taborgreat/robokyle-factum/band/software/README.md

# Band software

C firmware on the Pico SDK 2.2.0 (`firmware/`) plus MicroPython bench tools (`bench/`). The claw's firmware lives
in `claw/software/firmware` and speaks the same protocols. Pins: [../PINOUT.md](../PINOUT.md) (single source of truth). Wiring page: https://claude.ai/artifact/D63qQQRTtqdpi1PEdaQg2D

| dir | target | what |
|---|---|---|
| `firmware/` | Pico 2 W | EMG band: HAND-FACTUM / HAND-DIRECT / MOUSE / HAND-WIRED, config server, BLE HID mouse |
| `../../claw/software/firmware/` | Pico W | claw: hand API on :80, Feetech STS3215 bus, keepalive watchdog, cord |
| `bench/` | MicroPython | `band_bench.py` proves every wire; `listener.py` shows UDP frames on the laptop |

## Build (Windows, Git Bash)
Toolchain lives in `~/.pico-sdk/` (SDK 2.2.0 + submodules, ARM GCC 14.2, prebuilt pioasm/picotool); cmake and
ninja come from the repo's `.venv`. Nothing else to install.
```
sh band/software/firmware/build.sh     # -> band/software/firmware/build/emg_band.uf2
sh claw/software/firmware/build.sh     # -> claw/software/firmware/build/robokyle_hand.uf2
```
Hold BOOTSEL, plug the Pico in, copy the .uf2 onto the RPI-RP2 drive. Serial console on the USB CDC port at
any baud (`putty`, `screen`, or the MicroPico terminal).

## First-time setup
Edit the defaults in `band/software/firmware/src/config.c` and `claw/software/firmware/src/hcfg.c` (Wi-Fi profiles, Factum IP, hand IP, shared key)
before the first flash. After that, change everything from Factum: `POST /config` with header
`X-Factum-Key: <key>` and a partial JSON body (a `wifi` list replaces the whole list; passwords never leave the
devices in `GET /config`). Change the key from the default on first setup.

## Band behaviour
- Boot -> last mode. Button: tap = (reserved), double = next BT slot (MOUSE), 1 s = next mode, 2 s = ESTOP
  (hand modes), 3 s = pair (MOUSE). Two co-contractions within 1 s also switch HAND <-> MOUSE.
- HAND-FACTUM: joins Wi-Fi, classifies on-board, POSTs to the hand, streams UDP frames to Factum:5005.
- HAND-DIRECT: hosts the `RoboKyle` hotspot at 192.168.4.1, the hand joins it. No server needed.
- MOUSE: BLE HID mouse from gyro rates, 4 bonded host slots (blue / cyan / magenta / white), directed advertising
  to the bonded host, undirected while pairing. Flexor burst = left click, hold = drag; extensor burst = right
  click, hold + tilt = scroll; light flexor hold = clutch.
- HAND-WIRED: entered automatically when the hand answers hellos on the cord; radios off; leaves on unplug.
- Grip wheel: co-contraction 150 ms (hand empty) opens it; roll/pitch relative to entry point at 6 sectors
  (open, fist, pinch, tripod, point, palm); the hand previews at low torque; close by returning to centre, 1 s
  still, or 3 s total. Haptics: 1 short = change, 1 long = set, 2 short = cancel/mode, 2 s = ESTOP.
- Config API (port 80): `GET /status` open; `GET/POST /config`, `POST /calibrate {"phase":"rest|close|open|apply"}`
  (10 s captures; apply sets thresholds at 40 % / 25 % of the range), `POST /buzz {"ms":100}`,
  `POST /mode {"mode":0..2}` need the key.

## Hand behaviour
`POST /open`, `/close {"force":0..1}`, `/grip {"name":..,"preview":bool}`, `/stop`, `/estop`, `/keepalive`;
`GET /status`; `GET/POST /config` (key). Any command counts as a keepalive; 500 ms without one while closing ->
stop, then open. ESTOP opens at full torque and latches until power-cycle. Tap the local button = open; hold 2 s
= local ESTOP. Cord: the same commands as `{"cmd":"close","a":{"force":0.4}}` lines; `hello` is answered with
`{"hand":true,"s":{...status...}}`.

Servo positions (`pos_open`, `pos_closed`) and torque limits are in `hcfg` and must be set on the bench with the
claw assembled: move it by hand with torque off, read `GET /status` `pos` at each end.

## Status of the code
Compiles clean against SDK 2.2.0 with no warnings in our sources. Not yet run on hardware. The pieces most likely
to need a first-run fix: the BNO08x SHTP read sequence in `firmware/src/imu.c` (compare against Adafruit's
`Adafruit_BNO08x` HAL if it stalls), directed advertising parameters in `ble_mouse.c` (an iPhone may want
undirected + whitelist instead), and the Feetech register map in `claw/software/firmware/src/feetech.c` (verify against the STS3215
memory table).

## Signal conditioning (why the effort numbers are what they are)

Each EMG channel is sampled at 1 kHz and passed through a 20 Hz high-pass (two first-order sections) before
rectification, so the slow junction-voltage jumps a sliding dry plate produces are removed while muscle (20-500 Hz)
passes; the 20 ms effort frame is the mean of the rectified, filtered signal. A gyro jolt above 250 deg/s on the
BNO08x holds the last trusted effort for 150 ms instead of acting on the plates' movement. Re-run calibration
after changing either number: the effort scale is not the same as the old |v - 1.5| measure.

## Feedback (what Kyle sees and feels)

`feedback.c` runs after every 20 ms frame. The light bar turns **yellow** while the flexor is above its threshold,
**blue** for the extensor, **green** when both are, brightness following effort, so the co-contraction he needs to
open the wheel shows as green the moment he gets it. The motor gives one 30 ms tick on each close or open onset and
a 90 ms one on a co-contraction; the wheel's own cues are unchanged and win while it is open. With USB in and the
band idle the bar is a battery gauge (1 to 3 pixels, the top one breathing); amber breathing on one pixel means USB
is in but the switch is off. `cfg.feedback` = 0 off, 1 bar only, 2 bar + buzz (default). Config version is 4: the
first boot after flashing reloads defaults, so calibrate again.

## Addresses and who talks to whom

Four ways the band is used, and the band only ever addresses the hand in two of them:

| mode | band talks to | hand talks to |
|---|---|---|
| HAND-FACTUM | Factum only: UDP frames to `factum_host`:`factum_port` (5005), estop POST to `factum_path`/estop. Each frame carries `"h"`, the hand command the band would have sent, for Factum to relay | Factum |
| HAND-DIRECT | the hand, at `hand_ip` on the band's own access point (default 192.168.4.11) | the band's AP "RoboKyle" |
| HAND-WIRED | the hand over the PH3 cord | the cord |
| MOUSE | a phone or laptop over BLE | nothing |

There is no "hand on the home network" address. `factum_host` (default `api.factum.org`, a name or an IP) is
resolved by DNS as soon as Wi-Fi is up, retried every 10 s until it answers; plain HTTP and UDP only, the Pico build
has no TLS, so the server must expose the band endpoints without HTTPS or a TLS step gets added later. All keys are
settable from Factum through the config server; `factum_ip` is accepted and lands in `factum_host`. Config version 6.
Factum's relay (`factum/backend/src/relay.js`) turns `"h"` into motion: the virtual Brunel hand at `/brunel/` on the
server (always), and the claw over the band's own protocol plus the keepalive when Factum's Devices page says so.
