taborgreat/robokyle-factum/band/hardware/print/band_lid.stl

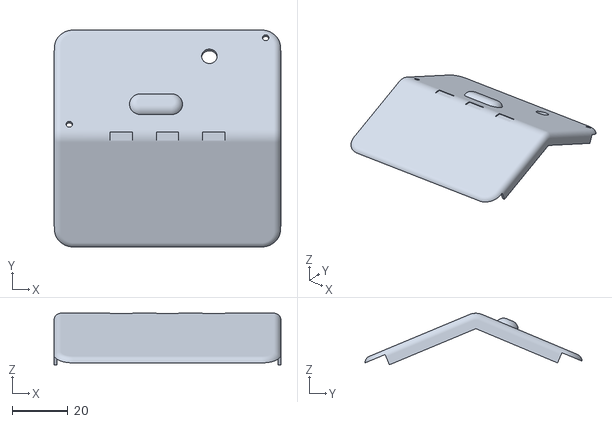
[picture p2: CAD file, 2026-10-01]
band/hardware/print/band_lid.stl
81.7 x 78.1 x 18.6
