taborgreat/robokyle-factum/band/hardware/print/band_box.stl

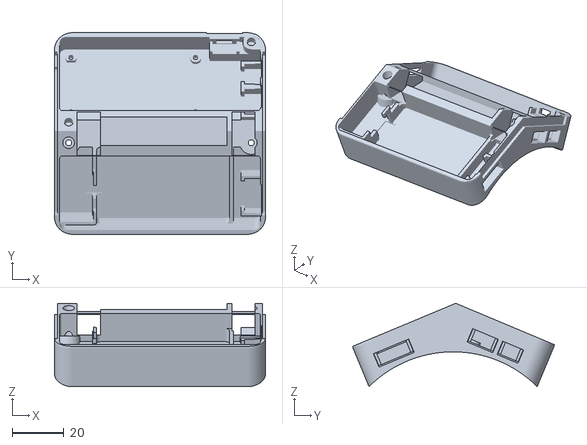
[picture p3: CAD file, 2026-09-29]
band/hardware/print/band_box.stl
81.7 x 78.1 x 32.3
