taborgreat/robokyle-factum/band/hardware/print/fa_module.stl

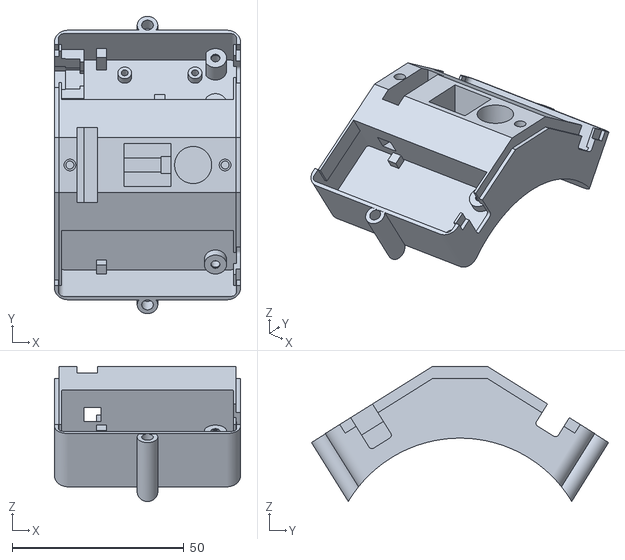
[picture p4: CAD file, 2026-09-29]
band/hardware/print/fa_module.stl
54.2 x 86.6 x 39.4
