taborgreat/robokyle-factum/band/hardware/print/fa_lid.stl

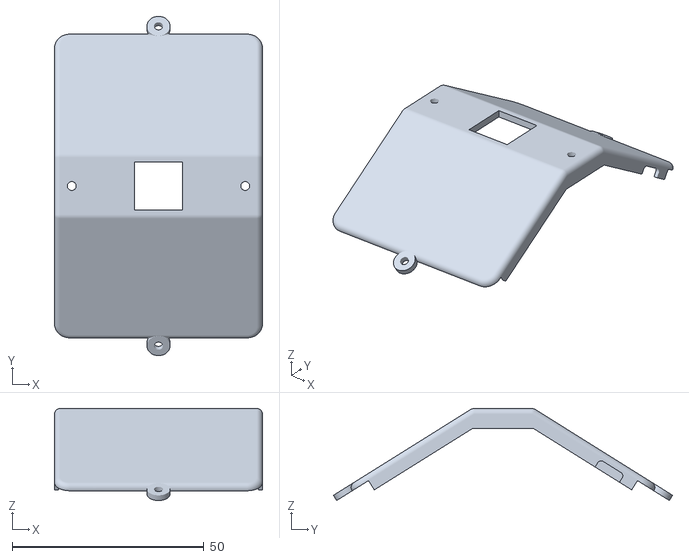
[picture p5: CAD file, 2026-09-29]
band/hardware/print/fa_lid.stl
54.2 x 88.4 x 24.0
