taborgreat/robokyle-factum/band/hardware/print/band_plate.stl

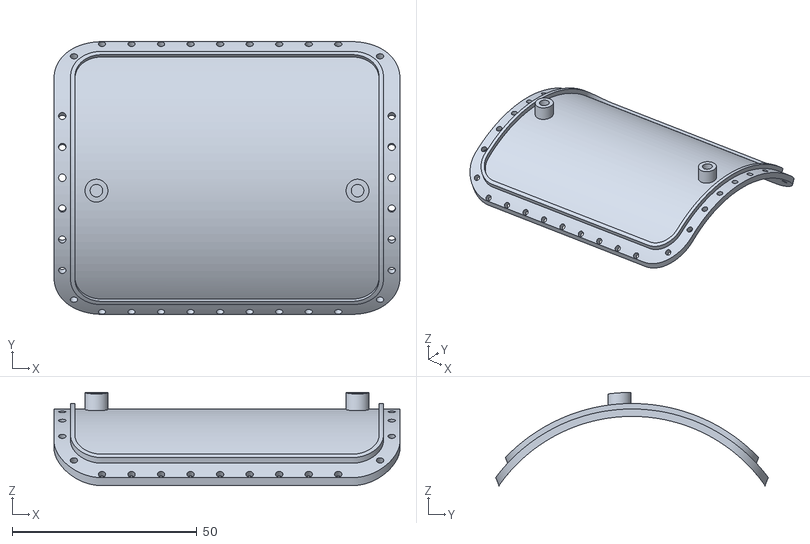
[picture p6: CAD file, 2026-09-26]
band/hardware/print/band_plate.stl
93.7 x 73.9 x 25.2
