taborgreat/robokyle-factum/band/hardware/print/electrode_cover.stl

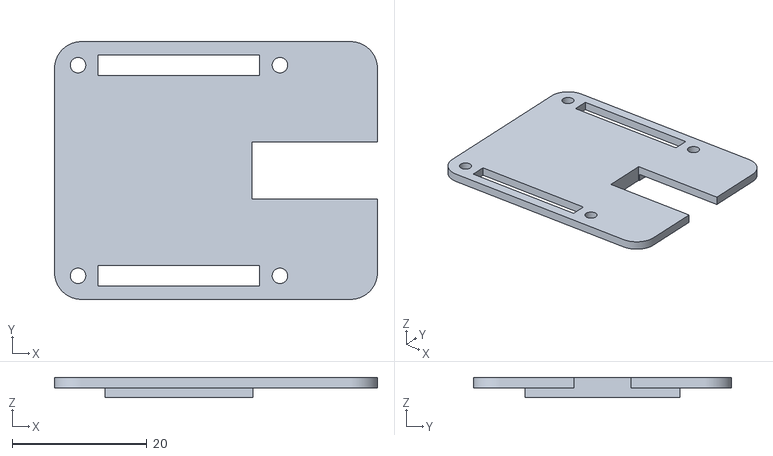
[picture p7: CAD file, 2026-09-26]
band/hardware/print/electrode_cover.stl
48.0 x 38.3 x 2.99
