taborgreat/robokyle-factum/band/hardware/print/electrode_frame.stl

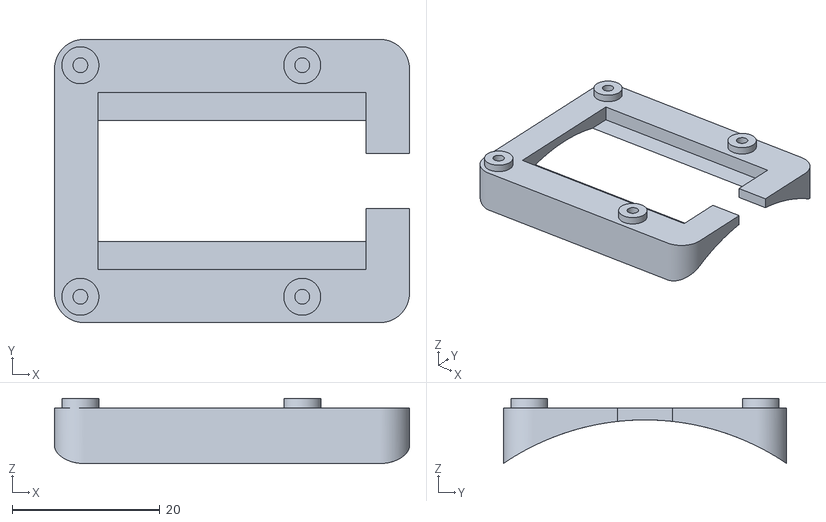
[picture p8: CAD file, 2026-09-26]
band/hardware/print/electrode_frame.stl
48.0 x 38.3 x 8.81
