taborgreat/robokyle-factum/band/hardware/print/fa_backer.stl

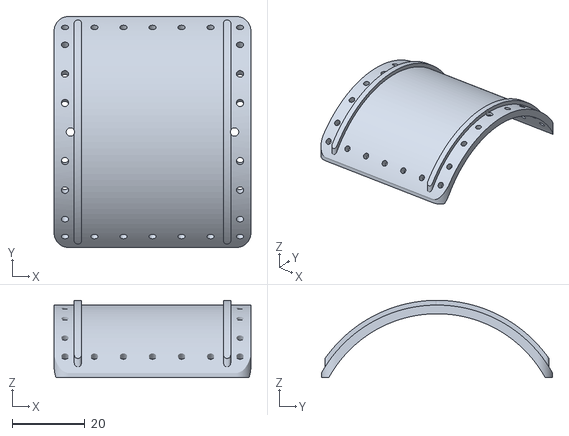
[picture p9: CAD file, 2026-09-26]
band/hardware/print/fa_backer.stl
54.2 x 63.6 x 21.3
