taborgreat/robokyle-factum/band/hardware/print/MANIFEST.md

# Print outputs (overwritten in place; check sizes in Bambu Studio)

| file | size mm (X x Y x Z) | volume | watertight | source version | date |
|---|---|---|---|---|---|
| band_box.stl | 81.7 x 78.1 x 32.3 | 32.3 cm3 | yes | v229_band_box | 2026-09-29 |
| band_lid.stl | 81.7 x 78.1 x 18.6 | 11.1 cm3 | yes | v238_band_lid | 2026-10-01 |
| band_plate.stl | 93.7 x 73.9 x 25.2 | 16.2 cm3 | yes | v188_band_plate | 2026-09-25 |
| electrode_cover.stl | 48.0 x 38.3 x 3.0 | 3.1 cm3 | yes | v158_fa_cover | 2026-09-24 |
| electrode_frame.stl | 48.0 x 38.3 x 8.8 | 4.4 cm3 | yes | v172_fa_frame | 2026-09-25 |
| fa_backer.stl | 54.2 x 63.6 x 21.3 | 10.0 cm3 | yes | v185_fa_backer | 2026-09-25 |
| fa_lid.stl | 54.2 x 88.4 x 24.0 | 8.2 cm3 | yes | v233_fa_lid | 2026-09-29 |
| fa_module.stl | 54.2 x 86.6 x 39.4 | 36.5 cm3 | yes | v232_fa_module | 2026-09-29 |
