taborgreat/robokyle-factum/band/software/firmware/src/btstack_config.h

// BTstack configuration: BLE peripheral only (HOGP mouse), 4 bonds in flash.
#pragma once
#define ENABLE_LE_PERIPHERAL
#define ENABLE_LE_SECURE_CONNECTIONS
#define ENABLE_LE_DATA_LENGTH_EXTENSION
#define ENABLE_LOG_INFO
#define ENABLE_LOG_ERROR
#define ENABLE_PRINTF_HEXDUMP
#define ENABLE_MICRO_ECC_FOR_LE_SECURE_CONNECTIONS
#define HCI_OUTGOING_PRE_BUFFER_SIZE 4
#define HCI_ACL_PAYLOAD_SIZE (255 + 4)
#define HCI_ACL_CHUNK_SIZE_ALIGNMENT 4
#define MAX_NR_HCI_CONNECTIONS 1
#define MAX_NR_SM_LOOKUP_ENTRIES 3
#define MAX_NR_WHITELIST_ENTRIES 4
#define MAX_NR_LE_DEVICE_DB_ENTRIES 4
#define MAX_NR_GATT_CLIENTS 0
#define MAX_NR_HIDS_CLIENTS 0
#define MAX_ATT_DB_SIZE 512
#define NVM_NUM_DEVICE_DB_ENTRIES 4
#define NVM_NUM_LINK_KEYS 0
#define ENABLE_ATT_DELAYED_RESPONSE
#define HAVE_EMBEDDED_TIME_MS
#define HAVE_ASSERT
#define HAVE_MALLOC
