taborgreat/robokyle-factum/(commit log)

2026-09-19 api landing pw protectiog coming soon for mods
2026-09-24 adjusted through holes to plate
    [band_box.stl, band_plate.stl]
2026-09-24 pucks, emg
    [band_box.stl, band_lid.stl, band_plate.stl, electrode_bar.stl, electrode_frame.stl, fa_backer.stl, fa_lid.stl, fa_module.stl]
2026-09-24 eklectrode updates and band updates
    [band_box.stl, band_plate.stl, electrode_frame.stl]
2026-09-26 build changes
    [band_box.stl, band_lid.stl, band_plate.stl, electrode_bar.stl, electrode_cover.stl, electrode_frame.stl, fa_backer.stl, fa_lid.stl]
2026-09-27 new charging module - redesign
    [band_box.stl, band_lid.stl, board_gauge.stl, fa_module.stl]
2026-09-27 clean up build process
    [fit_gauge.stl]
2026-09-28 measurements and updates
    [band_lid.3mf]
2026-09-29 updated viewer, hardware updates
    [band_box.stl, band_lid.stl, fa_lid.stl, fa_module.stl]
2026-10-01 update lid, main band box complete
    [band_lid.3mf, band_lid.stl]
